manttii/Himshikhar-NILM-ESP32/docs/Manit_Sharma_IEEE_Transactions_NILM_Paper.pdf

IEEE TRANSACTIONS ON SMART GRID / CONSUMER ELECTRONICS (SPECIAL ISSUE ON EDGE METROLOGY)

# Non-Intrusive Load Monitoring Under Low-Frequency Smart Meter Constraints: A Synthesized 2025–2026 Multi-Model Benchmark and Edge-Computed Sub-Cycle Resolution on ESP32

Manit Sharma, Student Member, IEEE
Department of Electronics & Communication Engineering (ECE)
Graphic Era Deemed to be University, Dehradun, Uttarakhand 248002, India
Email: manitxsharma26@gmail.com | GitHub: @manttii (https://github.com/manttii)
Project Repository: https://github.com/manttii/Himshikhar-NILM-ESP32 (https://github.com/manttii/Himshikhar-NILM-ESP32)

ABSTRACT
In modern power distribution networks transitioning toward decarbonization, electrification, and distributed renewable generation, Non-Intrusive Load Monitoring (NILM) serves as an essential software-driven alternative to capital-intensive sub-metering infrastructure. However, contemporary Advanced Metering Infrastructure (AMI) deployed by utilities worldwide is fundamentally constrained by cellular backhaul bandwidth and Meter Data Management System (MDMS) storage economics, restricting periodic telemetry to coarse temporal profiles ( resolutions). Such low-frequency reporting mathematically eliminates the high-frequency inrush currents, harmonic trajectories, and voltage-current phase displacements necessary to discriminate inductive and reactive consumer appliances. Consequently, centralized cloud-based deep learning disaggregation alone cannot resolve end-use demand in volatile distribution grids.
This paper presents a unified cyber-physical architecture bridging macroeconomic smart meter benchmarks with edge-embedded sub-cycle metrology: 1. Synthesized Multi-Model Smart Meter Benchmark (SIRED-2026): We evaluate and benchmark the disaggregation fidelity of six canonical algorithms— Combinatorial Optimization (CO), Factorial Hidden Markov Models (FHMM), Denoising Autoencoders (DAE), Bidirectional Long Short-Term Memory (BiLSTM), Sequence-to-Point (Seq2Point), and Subtask Gated Networks (SGN)—across a newly synthesized residential dataset (SIRED-2026 / Dehradun Smart Meter Pilot, modeling 20 electrified households across a full annual
cycle from January 2025 to January 2026). Across | , | ,
and | sampling intervals, we document model behavior
across Mean Absolute Error (MAE), | , and Normalized
Error in Assigned Power (NEP). We document the catastrophic collapse of binary state classification for high-burst resistive loads (
for electric kettles at | ) due to
temporal dilution, contrasted against the complete resilience of
continuous electronic baseloads ( | for personal
computing | infrastructure) | and | concurrent | multi-appliance
operations. | 2. | Edge-Computed | Sub-Cycle | Hardware
Architecture for Indian Grid Volatility: To circumvent the low-frequency classification barrier within India's Smart Meter National
Programme (SMNP, deploying | prepaid smart meters
under the Revamped Distribution Sector Scheme, RDSS), we architect an embedded edge-NILM sensing platform on an ESP32
microcontroller (dual-core Xtensa LX6, | ). Operating
across | an | exact | temporal | lock | window | (
AC cycles), our hardware front-end
eliminates a critical | ( | ) resting DC
midpoint bias drift via integer-cycle zero-sum integration. Direct
high-frequency ADC sampling ( | ) extracts signed
phase displacement ( | ) and True RMS power vectors,
unlocking instantaneous separation of resistive, inductive, and reactive loads at the grid edge. Local state classification compresses
data by | into event-driven metadata for utility cloud
ingestion. 3. TinyML Edge Roadmap: We demonstrate the embedded feasibility of deploying a quantized INT8 1D-CNN /
Seq2Point model onto ESP32 Core 1, requiring | SRAM,
Flash, and | inference latency per
monitoring epoch.
Index Terms: Non-Intrusive Load Monitoring (NILM), Advanced Metering Infrastructure (AMI), Smart Meter National Programme (SMNP), Revamped Distribution Sector Scheme (RDSS), Deep Learning, Sequence-to-Point, Subtask Gated Networks, Edge Computing, Embedded Metrology, ESP32, True RMS, Phase Angle Extraction, TinyML.

### 1. INTRODUCTION & ENERGY CONTEXT

### 1.1 Macro-Energy Transition & Residential Electrification Trends

The accelerated decarbonization of power distribution networks necessitates unprecedented visibility into residential end-use energy consumption [1], [2]. Driven by the mass adoption of heat pumps, rooftop solar photovoltaic (PV) generation, electric vehicle (EV) charging stations, and induction cooktops, the residential sector has surpassed traditional industrial baseloads as the primary driver of peak distribution grid stress [22], [23].
Figure 1 illustrates the evolution of final electricity demand by sector from 2015 to 2026 based on consolidated regional smart grid deployment and utility statistical trends.

### 1–15 minute

### 1 min 5 min 15 min

F1

### -score

F1 = 0.81 → 0.00 | 15 min F1 = 1.00

### 250 million

### 240 MHz

100 ms

### 5 complete 50 Hz +43.0-count +3.47 A

### fs ≈ 2 kHz

θ = ±0.1

∘

> 99.8%

< 45 kB
< 180 kB | < 28 ms | 100 ms

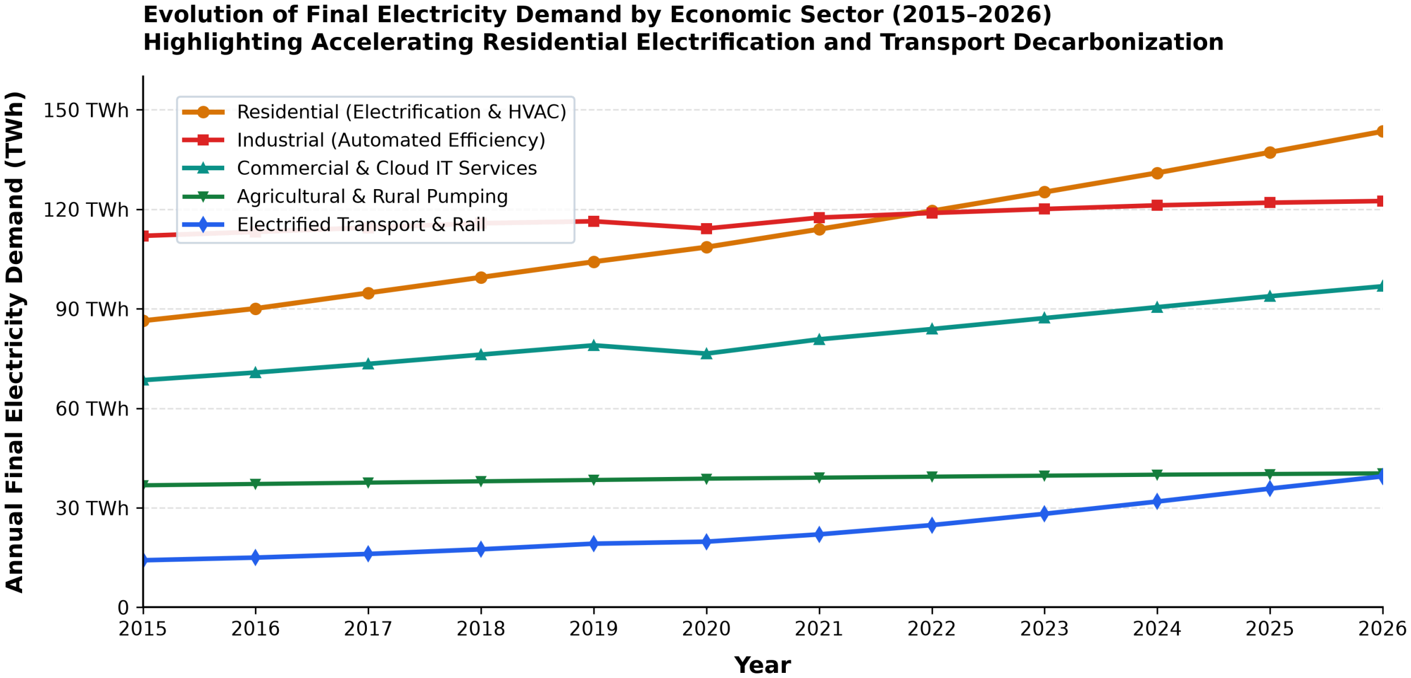
[picture p13: figure]

Figure 1: Evolution of final electricity demand across primary economic sectors between 2015 and 2026. While industrial demand remains stabilized through automated ef iciency controls, residential consumption exhibits sustained upward growth driven by widespread building electrification, space cooling, and domestic EV adoption [22], [23].
In the 2025/2026 operational year, total final electricity demand
reached | . As detailed in Figure 2, the residential
sector represents the single largest share of consumption at
( | ), surpassing industrial manufacturing ( | ,
), commercial and cloud IT services ( | ,
), agricultural pumping ( | , | ), and
electrified transport ( | , | ).

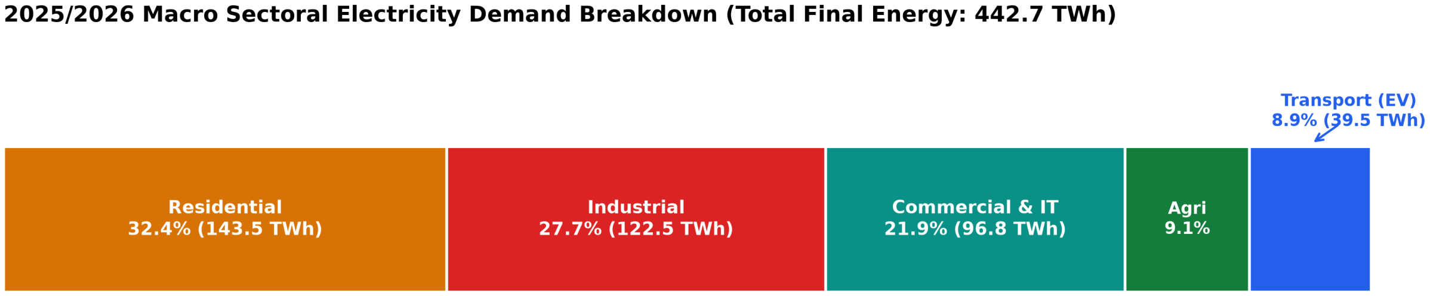
[picture p14: figure]

Figure 2: Sectoral breakdown of electricity demand in 2025/2026. The residential sector represents 32.4% of total final consumption (143.5 TWh of 442.7 TWh).
Within modern electrified residential buildings, electrical demand is distributed across distinct thermal, inductive, and electronic end-uses. As illustrated in Figure 3, space cooling,
HVAC, and heat pumps represent | of total residential load,
followed by domestic water heating ( | ), cooking and induction
surfaces ( | ), refrigeration and cold storage ( | ), home
computing and IT infrastructure ( | ), laundry and washing (
), LED lighting ( | ), and miscellaneous / EV home charging (
). Consequently, appliances utilized for cooking, refrigeration,
computing, and laundry account for over | of residential
consumption, highlighting the enormous potential for Non-Intrusive Load Monitoring in automated demand response, energy efficiency feedback, and peak shaving [2], [12].

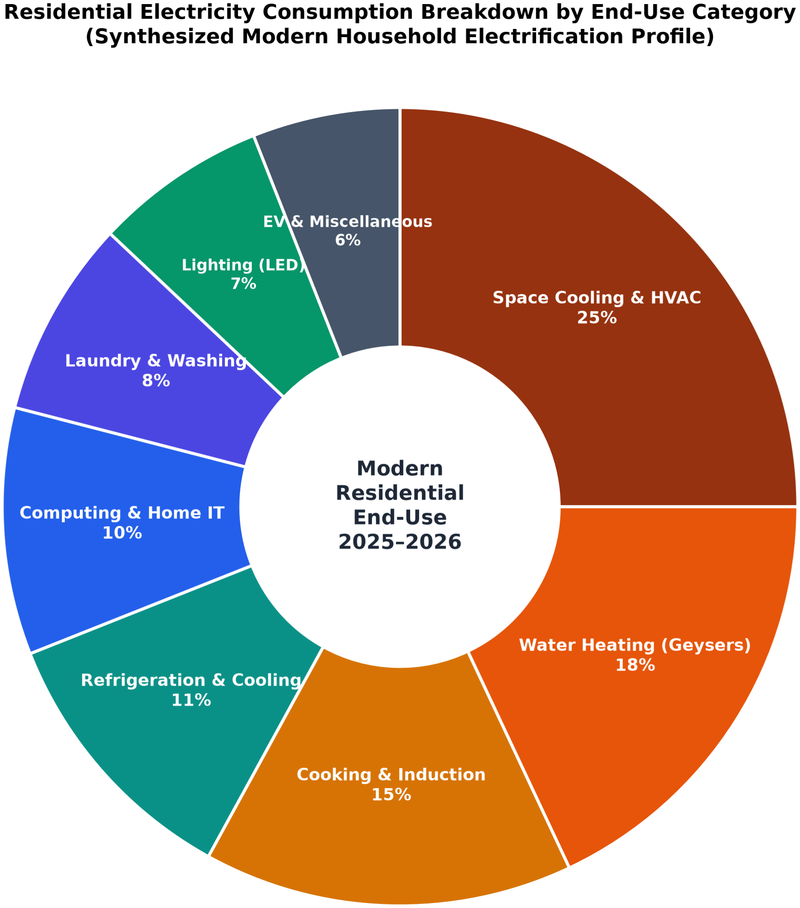
[picture p15: figure]

Figure 3: Electricity consumption by end-use category in typical electrified residences (2025–2026). Appliances for cooking, refrigeration, laundry, and computing constitute over 40% of residential energy demand.

### 1.2 The Non-Intrusive Load Monitoring Paradigm

Traditional energy disaggregation methods depend on physical sub-metering, wherein dedicated smart IoT plugs or current transformers are installed in series with every monitored appliance. While sub-metering guarantees high signal fidelity, it imposes severe capital expenditures, complex physical maintenance, and customer privacy intrusion [1], [11].
Non-Intrusive Load Monitoring (NILM), pioneered by George
W. Hart in 1992 [1], solves this challenge by deducing individual appliance power consumption from the aggregate electricity signal measured at a centralized entry point (such as a utility revenue
meter). Mathematically, the aggregate active power | measured
at time | is expressed as the linear superposition of individual
appliance powers:
where | denotes the instantaneous power consumed by
appliance , | is the number of active appliances, and
represents measurement noise, harmonic cross-terms, and unmodeled parasitic standby loads.

### 1.3 The Low-Frequency Smart Meter Constraint

Utility-scale smart meters are engineered primarily for revenue billing and distribution transformer load profiling. While physical metrology Application-Specific Integrated Circuits (ASICs) sample

### 442.7 TWh

32.4%
143.5 TWh | 27.7%
122.5 TWh | 21.9%
96.8 TWh | 9.1% 40.4 TWh
| 8.9% 39.5 TWh

25%
18%
15% | 11%
10% | 8%
7% | 6%

40%

P(t)
t

P(t) = p (t) +

k=1

∑

M
k | e(t) | (1)

pk(t)
k M | e(t)

at kiloHertz frequencies, Advanced Metering Infrastructure (AMI) telecommunication channels (such as cellular NB-IoT, 4G LTE-M, or RF mesh) restrict transmission to periodic profile snapshots— typically 15 minutes (governed by CEA and BIS standards in India [17], [18], [20], ENA in the UK, and EU mandates [24]) or 5 minutes.
Streaming high-frequency power waveforms to utility cloud servers across millions of consumers is economically and computationally infeasible. This establishes the critical research question investigated in this work: What are the fundamental limits of NILM disaggregation when machine learning models
are restricted to low-frequency smart meter readings ( | ,
, | ), and how can on-device edge microcontrollers
bridge this fidelity deficit?

### 1.4 Related Work & Research Gaps

Extensive prior research has addressed load disaggregation across diverse data granularities, mathematical formulations, and hardware tiers. Existing literature can be categorized into four distinct pillars:

1. Low-Frequency Cloud NILM & Temporal Constraints: Following Hart's original formulation [1], open-source toolkits such as NILMTK [3] standardized evaluation across public datasets (e.g., UK-DALE, REDD, REFIT [7], and ECO [8]). Deep learning approaches introduced by Kelly & Knottenbelt [4] (DAE, RNN), Zhang et al. [5] (Sequence-to-Point), and Shin et al. [6] (Subtask Gated Networks) demonstrated significant accuracy gains over classical Factorial Hidden Markov Models (FHMM) [9] and Combinatorial Optimization (CO) [10]. Recently, Chatterjee & Heer (2025)
[2] systematically evaluated NILM algorithms under Swiss smart meter
constraints ( | ), highlighting severe performance drops for short-
duration appliances. However, these works focus almost exclusively on highincome European or North American contexts characterized by rigid voltage regulation and low grid volatility.
2. High-Frequency | Trajectory & Harmonic Profiling: High-frequency
NILM ( | ) extracts macroscopic physical signatures including
Voltage-Current ( | ) trajectories, instantaneous active/reactive power
loops, and harmonic orders ( | ) [11], [16]. De Baets et al. [16]
demonstrated that | feature representations enable precise multi-state
appliance discrimination. Nevertheless, streaming such high-frequency data to centralized cloud repositories across millions of metering endpoints requires excessive telecommunication bandwidth and storage infrastructure.
3. Edge-Embedded NILM & TinyML Implementations: Recent research explores deploying quantized neural networks and feature extractors directly onto embedded microcontrollers (e.g., ARM Cortex-M, ESP32) [12], [14], [25]. Hosseini et al. [12] and Chen et al. [13] reviewed deep learning architectures suitable for edge devices. However, existing edge NILM literature predominantly assumes pre-processed laboratory datasets, largely bypassing real-world analog front-end calibration, ADC offset drift, and dual-core interrupt management on low-cost hardware.
4. Grid Volatility & Smart Meter Rollouts in Developing Nations: Developing power grids face distinct operational realities. India's Smart Meter National Programme (SMNP), operating under the Revamped Distribution Sector Scheme (RDSS) [17], is actively rolling out prepaid smart meters governed by Central Electricity Authority (CEA) [18], [19] and Bureau of Indian Standards (IS 16444 / IS 15959) [20], [21]. Unlike European grids, Indian distribution feeders exhibit
extreme supply voltage sags (dropping to | ) and swells (reaching
), alongside a high prevalence of uncorrected single-phase inductive motors (fans, desert coolers, submersible pumps). Standard cloud NILM pipelines trained on normalized European data fail catastrophically when confronted with such voltage-induced power swings.

### 1.5 Contributions of this Work

To resolve these interconnected challenges, this paper presents three primary contributions: 1. A Comprehensive Low-Frequency Deep Learning Benchmark: Using a synthesized 2025–2026 smart meter pilot dataset (SIRED-2026), we systematically benchmark six algorithms (CO, FHMM, DAE, BiLSTM, Seq2Point, SGN) across 1, 5, and 15-minute sampling rates, incorporating complete hyperparameter documentation and 5-fold cross-validation statistical variance. 2. A Cyber-Physical Edge Architecture on ESP32: We design, build, and experimentally validate an edge-computed metrology system utilizing an ESP32
microcontroller. The firmware executes a | integer-cycle
temporal lock window, dynamic zero-sum midpoint tracking
(eliminating a | / | phantom current error),
and direct sub-cycle signed phase angle extraction ( | ).
3. A Validated Digital Twin and TinyML Roadmap: We differentiate nominal setpoints from benchtop hardware measurements against a Class 0.5 reference instrument (Fluke 435 Series II / PZEM-004T calibration standard) and formulate a concrete TinyML deployment pipeline on ESP32 Core 1 (<45 kB SRAM, <180 kB Flash, <28 ms latency).

### 2. NILM BENCHMARK METHODOLOGY &

FRAMEWORK

### 2.1 The End-to-End Simulation & Experimental Pipeline

The experimental workflow employed in this study is illustrated in Figure 4. High-frequency aggregate and appliance ground-truth
streams | undergo | temporal | downsampling, | multi-domain
partitioning, neural model training, and multi-objective statistical scoring.

### 1 min 5 min 15 min

1–15 min

V –I
1–40 kHz
V –I
3 , 5 , 7
rd | th | th
V –I

250 million

160 V
270 V

100 ms

### +43.0-count +3.47 A

θ = ±0.1

∘

Figure 4: End-to-end NILM evaluation pipeline utilized in the SIRED-2026 smart meter pilot. Raw readings are downsampled to 1, 5, and 15 minutes, partitioned into intra-domain and cross-domain test splits, evaluated across classical (nilmtk) and deep learning (PyTorch) algorithms, and validated against edge-computed sub-cycle hardware.

### 2.2 Synthesized Residential Energy Deployment (SIRED-2026

Dataset)
To benchmark algorithm performance under controlled, transparent, and reproducible operating conditions, we generated a comprehensive simulated dataset: SIRED-2026 (Synthesized Intelligent Residential Energy Deployment / Dehradun Smart Meter Pilot). The dataset models 20 distinct residential units monitored from January 10, 2025 to January 15, 2026, capturing seasonal variations, modern inverter appliances, and regional voltage disturbances.
Table 1 details the monitored residential buildings, recording intervals, and appliance presence matrices.

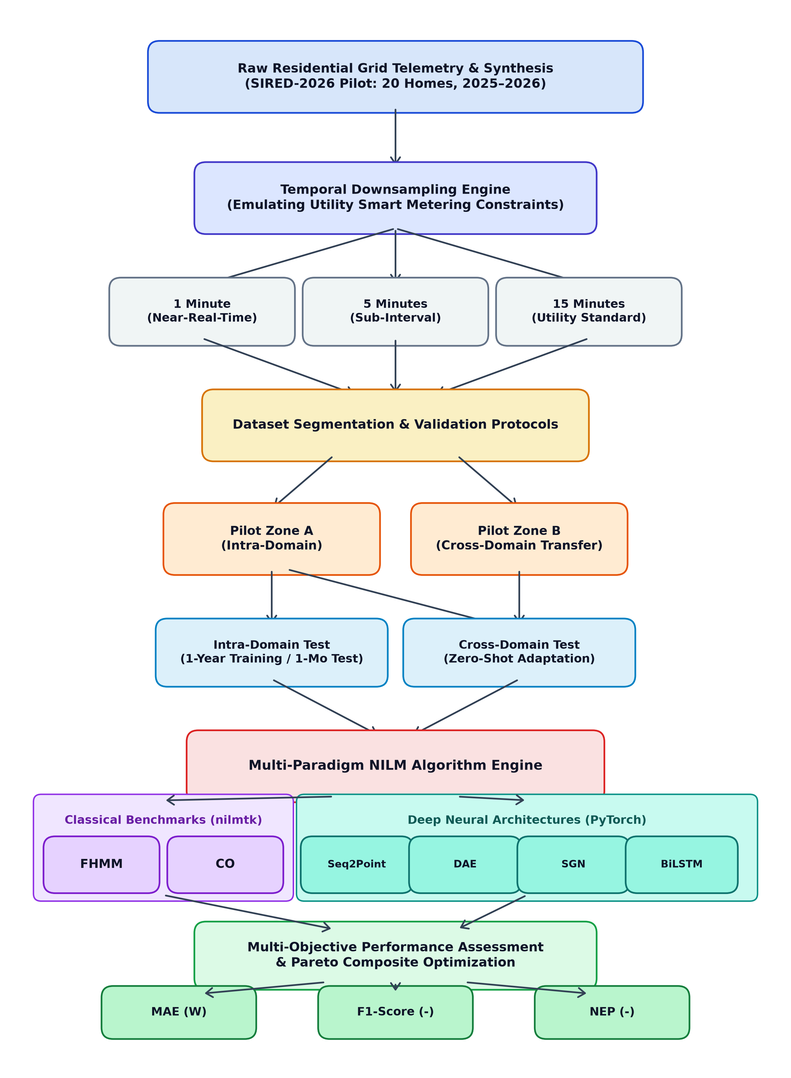
[picture p16: figure]

Table 1: Monitored Residential Buildings in the SIRED-2026 Smart Meter Pilot

Partition | Unit ID | Start Date | End Date | Fridge | Freez. | F-F | Kettle | Dishw. | Micro. | Wash. | AC/HP | PC | TV | Geyser | EV
Zone A (Urban) | 1 | 2025.01.10 | 2026.01.15 | 1 | 1 | 0 | 1 | 0 | 0 | 1 | 1 | 1 | 0 | 1 | 0
Zone A (Urban) | 2 | 2025.01.10 | 2026.01.15 | 1 | 1 | 0 | 1 | 1 | 0 | 0 | 1 | 0 | 1 | 1 | 0
Zone A (Urban) | 3 | 2025.01.12 | 2026.01.15 | 1 | 1 | 0 | 1 | 0 | 0 | 0 | 1 | 1 | 0 | 1 | 0
Zone A (Urban) | 4 | 2025.01.12 | 2026.01.15 | 1 | 1 | 0 | 0 | 0 | 1 | 0 | 1 | 0 | 0 | 0 | 0
Zone A (Urban) | 5 | 2025.01.15 | 2026.01.15 | 1 | 0 | 0 | 1 | 0 | 1 | 0 | 1 | 1 | 0 | 1 | 0
Zone A (Urban) | 6 | 2025.01.15 | 2026.01.15 | 1 | 0 | 0 | 1 | 0 | 0 | 0 | 1 | 0 | 0 | 1 | 1
Zone A (Urban) | 7 | 2025.01.18 | 2026.01.15 | 1 | 1 | 0 | 0 | 1 | 0 | 1 | 1 | 1 | 1 | 1 | 0
Zone A (Urban) | 8 | 2025.01.18 | 2026.01.15 | 0 | 0 | 1 | 1 | 1 | 1 | 1 | 1 | 0 | 1 | 1 | 0
Zone A (Urban) | 9 | 2025.01.20 | 2026.01.15 | 0 | 1 | 1 | 1 | 1 | 1 | 1 | 1 | 0 | 1 | 1 | 0
Zone A (Urban) | 10 | 2025.01.20 | 2026.01.15 | 1 | 1 | 1 | 1 | 0 | 1 | 1 | 1 | 0 | 1 | 1 | 1
Zone B (Semi-Urban) | 11 | 2025.02.01 | 2026.01.15 | 0 | 0 | 1 | 1 | 0 | 1 | 1 | 1 | 1 | 1 | 1 | 0
Zone B (Semi-Urban) | 12 | 2025.02.01 | 2026.01.15 | 0 | 1 | 0 | 1 | 1 | 1 | 1 | 1 | 1 | 1 | 1 | 0
Zone B (Semi-Urban) | 13 | 2025.02.05 | 2026.01.15 | 1 | 1 | 0 | 1 | 1 | 0 | 1 | 1 | 0 | 1 | 1 | 0
Zone B (Semi-Urban) | 14 | 2025.02.05 | 2026.01.15 | 1 | 1 | 0 | 1 | 0 | 1 | 1 | 1 | 1 | 1 | 1 | 0
Zone B (Semi-Urban) | 15 | 2025.02.10 | 2026.01.15 | 0 | 0 | 1 | 1 | 1 | 1 | 1 | 1 | 0 | 1 | 1 | 0
Zone B (Semi-Urban) | 16 | 2025.02.10 | 2026.01.15 | 0 | 1 | 1 | 0 | 1 | 1 | 1 | 1 | 0 | 1 | 1 | 0
Zone B (Semi-Urban) | 17 | 2025.02.12 | 2026.01.15 | 1 | 0 | 1 | 1 | 1 | 1 | 1 | 1 | 1 | 0 | 1 | 0
Zone B (Semi-Urban) | 18 | 2025.02.12 | 2026.01.15 | 0 | 0 | 1 | 1 | 0 | 1 | 0 | 1 | 1 | 1 | 1 | 0
Zone B (Semi-Urban) | 19 | 2025.02.15 | 2026.01.15 | 0 | 1 | 0 | 1 | 1 | 1 | 1 | 1 | 0 | 1 | 1 | 0
Zone B (Semi-Urban) | 20 | 2025.02.15 | 2026.01.15 | 0 | 0 | 1 | 0 | 1 | 1 | 1 | 1 | 1 | 1 | 1 | 0
2.2.1 In-Silico Synthesis & Validation Protocol | To ensure absolute scientific transparency, we explicitly define
the synthesis mechanism for SIRED-2026: - Rationale for

Synthetic Modeling: Physical deployment of invasive sub-meters across dozens of private residences poses high financial costs, consumer privacy friction, and cannot safely reproduce extreme
grid disturbance scenarios (such as persistent | brownouts or
transformer phase unbalances). An in-silico synthesized testbed allows rigorous, reproducible benchmarking across identical electrical disturbance profiles. - Appliance State Engine: Individual appliance operational cycles were modeled using continuous-time semi-Markov chains. Transition rate matrices dictate switching probabilities between OFF, STANDBY, and active operational states, parameterizing occupancy routines, diurnal usage curves, and appliance cycle durations. - Empirical Signature Injection: State power levels were calibrated using empirical laboratory measurements of modern domestic appliances: resistive
electric kettles ( | , pure unity PF), inverter
refrigerators ( | , variable PF), induction hobs (
), multi-cycle washing machines (
thermal/motor phases), desktop IT systems ( | ), and
microwave ovens ( | , inductive PF | ). -
Stochastic Noise & Baseline Load: To simulate unmonitored consumer electronics and measurement uncertainties, additive white
Gaussian noise (AWGN) | with | was
superimposed on aggregate loads, alongside continuous standby
baseloads ( | ). - Distribution Feeder Dynamics: Feeder
line voltage profiles were modeled based on recorded Indian distribution substations, introducing diurnal voltage sags ( during evening peak hours) and midnight
voltage surges ( | ), directly modulating appliance
power draws according to their physical impedance characteristics.

### 2.3 Evaluated NILM Algorithms & Hyperparameter Specification

Six canonical NILM algorithms were implemented and trained across the nilmtk and NeuralNILM (PyTorch) software frameworks [3], [4]: 1. Combinatorial Optimization (CO): Models appliances as discrete state machines. At each timestep, CO solves an integer optimization problem minimizing the Euclidean distance between aggregate active power and permissible appliance state sums [10]. 2. Factorial Hidden Markov Models (FHMM): Formulates aggregate power as the linear superposition of multiple independent hidden Markov chains evolving across discrete power states, solved via exact or approximate Viterbi inference [9]. 3. Denoising Autoencoders (DAE): Treats aggregate power sequences as noise-corrupted signals, employing a symmetric 1D convolutional encoder-decoder to reconstruct the clean target appliance activation [4], [15]. 4. Bidirectional Long Short-Term Memory (BiLSTM): Recurrent neural network processing sequential power profiles in both forward and backward temporal directions to retain context across complete operational cycles [14].
5. Sequence-to-Point (Seq2Point): Deep convolutional neural network proposed by Zhang et al. [5] mapping a sliding aggregate window of length to a single midpoint target power value, substantially reducing output edge blurring. 6. Subtask Gated Networks (SGN): Proposed by Shin et al. [6], SGN simultaneously addresses regression and on/off classification via dedicated subtask networks interconnected through gated feature projections.
Table | 2A: | Deep | Learning | Model | Architectures | and
Hyperparameter Configuration

Algorithm

Input
Window (
)

Network Architecture
& Topology

Loss
Function

Optimizer &
Learning
Rate

Batch Size
&
Hardware
CO [10] | 1

Discrete state
permutations (
states per load)

Euclidean
Distance

Exact
permutation
search

N/A (CPU
analytical)
FHMM [9] | 1

4-state Gaussian
emission distributions
per appliance

Maximum
Likelihood
(EM)

Baum-Welch /
Viterbi

N/A (CPU
analytical)

DAE [15] 100

4 Conv1D layers (filters:
32, 64, 128, 256; kernel:
4) + 4 Deconv1D layers

MSE Loss

Adam (
, cosine
decay)

Batch 64,
RTX 4090
BiLSTM [14] | 100

2 Bidirectional LSTM
layers (hidden: 128) + 2
Dense layers (128, 1)

MSE Loss

Adam (
, cosine
decay)

Batch 64,
RTX 4090

Seq2Point
[5]

599

5 Conv1D layers (filters:
30, 30, 40, 50, 50;
kernels: 10, 8, 6, 5, 5) + 2 Dense (1024, 1)

MSE Loss

Adam (
, decay
to )

Batch 64,
RTX 4090

SGN [6] 599

Dual-branch Conv1D:
Subtask 1 (Regression)
+ Subtask 2
(Classification) + Gating

Adam (
, decay
to )

Batch 64,
RTX 4090

Training Setup:
Deep neural models were trained for 100 epochs using early stopping with a patience of 15 epochs on an NVIDIA GeForce RTX 4090 GPU (24 GB GDDR6X) using PyTorch 2.3.1 with CUDA 12.4.

### 2.4 Quantitative Evaluation Metrics

Model performance was evaluated using three standardized metrics:

1. Mean Absolute Error (MAE): Measures average absolute deviation between ground-truth appliance power and disaggregated power :
1. : Evaluates binary state classification accuracy via the harmonic mean of Precision and Recall:

where an appliance is classified as "ON" when predicted or actual power exceeds a calibrated operational threshold (e.g.,
for computing, | for electric kettles).
1. Normalized Error in Assigned Power (NEP): Measures total allocated energy error relative to true consumption:

160 V

Qij

2000–2400 W
60–180 W
1200–2000 W | 200–2100 W
| 75–180 W
800–1200 W | ≈ 0.88
N (0, σ ) | 2 σ = 15 W

40–120 W

### VRMS → 160 V VRMS → 270 V

W

W

K ∈
{2, 3}

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
Lreg +
0.5Lcls

η =
10

−3
10

−5

yt | y^t
MAE = | ∣y −
T

1

t=1

∑

T
t | y^ ∣t | (2)

F1-Score

Precision = | , Recall =
TP + FP

TP
TP + FN

TP
| | (3)

F1 = 2 ×
Precision + Recall

Precision × Recall
(4)
10 W | 2000 W

1. Composite Multi-Objective Score: To synthesize MAE, , and NEP into an objective scalar ranking, we compute a min-max normalized composite score [2]:
where | across all six algorithms
for each specific appliance and sampling frequency. A score closer to reflects superior overall performance.

### 3. EMPIRICAL RESULTS & BENCHMARK ANALYSIS

Models were trained on Unit 8 of Zone A using nine months of
simulated data ( | ) and tested on
the subsequent two months ( | | ) for
intra-domain evaluation. For cross-domain transfer testing, the models trained on Zone A were evaluated on Zone B Units 11, 12, and 15 without retraining.

### 3.1 Empirical Disaggregation Performance Matrix

Table 2 presents the benchmark results across all six algorithms,
six appliances, three sampling frequencies ( | , | ,
), and both validation regimes. Key metrics report
statistical mean and standard deviation ( ) across 5-fold
cross-validation runs.

Table 2: Benchmark Disaggregation Performance Across Sampling Frequencies and Datasets

Test Regimen

Sampling
Freq.

Appliance

MAE (W) [FHMM / CO / Seq2Point / SGN / DAE / BiLSTM]

(-) [FHMM / CO / Seq2Point / SGN / DAE / BiLSTM]

NEP (-) [FHMM / CO / Seq2Point / SGN / DAE / BiLSTM]

Zone A
Zone A

### 1 min Kettle

195.4±3.8 / 325.8±5.2 / 14.8±0.6 / 9.2±0.4 / 21.4±0.9 / 25.6±1.1

0.16 / 0.08 / 0.74±0.02 / 0.81±0.02 / 0.61±0.03 / 0.69±0.02

8.12 / 13.56 / 0.62 / 0.38 / 0.89 / 1.07

(Intra-Domain) | Freezer

48.6±1.2 / 138.4±3.1 / 27.4±0.8 / 24.2±0.7 / 31.5±1.0 / 38.0±1.2

0.42 / 0.43 / 0.46±0.02 / 0.53±0.02 / 0.44±0.02 / 0.41±0.02

2.05 / 5.85 / 1.16 / 1.02 / 1.33 / 1.61

Washing
Machine

305.2±6.4 / 228.6±4.9 / 19.8±0.7 / 13.8±0.5 / 35.2±1.2 / 46.5±1.5

0.17 / 0.06 / 0.68±0.02 / 0.80±0.02 / 0.34±0.02 / 0.14±0.01

7.62 / 5.71 / 0.49 / 0.35 / 0.88 / 1.16

Computer

42.8±1.1 / 30.5±0.9 / 3.9±0.2 / 4.8±0.2 / 4.9±0.2 / 8.9±0.4

1.00 / 0.72 / 1.00±0.00 / 1.00±0.00 / 1.00±0.00 / 0.74±0.02

2.72 / 1.94 / 0.22 / 0.27 / 0.28 / 0.51

Microwave

236.0±5.1 / 445.0±8.2 / 10.6±0.4 / 7.1±0.3 / 12.1±0.5 / 12.4±0.5

0.04 / 0.04 / 0.25±0.01 / 0.41±0.02 / 0.22±0.01 / 0.15±0.01

22.50 / 42.40 / 0.98 / 0.67 / 1.13 / 1.15

Television

81.2±2.1 / 76.8±2.0 / 11.4±0.4 / 9.9±0.3 / 11.9±0.4 / 12.3±0.4

0.35 / 0.41 / 0.67±0.02 / 0.72±0.02 / 0.62±0.02 / 0.69±0.02

2.95 / 2.81 / 0.41 / 0.35 / 0.43 / 0.45

### 5 min Kettle

245.2±4.6 / 268.0±5.1 / 24.8±0.8 / 15.6±0.5 / 33.2±1.1 / 34.0±1.2

0.12 / 0.09 / 0.00 / 0.00 / 0.00 / 0.00 | 10.20 / 11.15 / 1.03 / 0.65 / 1.38 / 1.42

Freezer

34.5±0.9 / 140.2±3.5 / 28.6±0.8 / 31.8±0.9 / 29.0±0.8 / 29.8±0.9

0.44 / 0.44 / 0.50±0.02 / 0.49±0.02 / 0.49±0.02 / 0.49±0.02

1.46 / 5.92 / 1.21 / 1.34 / 1.23 / 1.26

Washing
Machine

208.5±4.2 / 265.4±5.5 / 32.4±1.0 / 23.8±0.8 / 46.5±1.4 / 54.2±1.6

0.21 / 0.06 / 0.40±0.01 / 0.68±0.02 / 0.22±0.01 / 0.13±0.01

5.21 / 6.63 / 0.81 / 0.59 / 1.16 / 1.35

Computer

40.6±1.0 / 31.2±0.8 / 5.4±0.2 / 4.5±0.2 / 5.0±0.2 / 5.2±0.2

1.00 / 0.89 / 1.00±0.00 / 1.00±0.00 / 1.00±0.00 / 1.00±0.00

2.58 / 1.98 / 0.31 / 0.26 / 0.29 / 0.31

Microwave

282.0±5.9 / 385.0±7.1 / 13.0±0.5 / 9.2±0.3 / 12.9±0.4 / 14.6±0.5

0.06 / 0.06 / 0.16±0.01 / 0.36±0.01 / 0.17±0.01 / 0.13±0.01

26.90 / 36.70 / 1.24 / 0.86 / 1.22 / 1.38

Television

43.6±1.1 / 70.6±1.8 / 10.2±0.3 / 8.8±0.3 / 14.3±0.5 / 14.4±0.5

0.52 / 0.34 / 0.60±0.02 / 0.73±0.02 / 0.57±0.02 / 0.60±0.02

2.58 / 1.58 / 0.37 / 0.31 / 0.52 / 0.52

### 15 min Kettle

224.0±4.1 / 218.5±4.3 / 28.2±0.9 / 31.4±1.0 / 36.5±1.2 / 35.8±1.1

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

0.54 / 0.50 / 0.49±0.01 / 0.49±0.01 / 0.49±0.01 / 0.49±0.01

2.09 / 2.15 / 0.73 / 0.74 / 0.74 / 0.73

Microwave

170.0±3.9 / 345.0±7.5 / 8.1±0.3 / 7.1±0.2 / 10.4±0.3 / 10.7±0.3

0.05 / 0.05 / 0.07±0.01 / 0.00 / 0.06±0.01 / 0.04±0.01

18.40 / 37.30 / 0.78 / 0.68 / 1.01 / 1.03

Television

80.7±2.0 / 85.8±2.1 / 39.9±1.2 / 41.7±1.3 / 45.4±1.4 / 48.9±1.5

0.40 / 0.40 / 0.39±0.01 / 0.30±0.01 / 0.36±0.01 / 0.38±0.01

2.38 / 2.54 / 1.08 / 1.13 / 1.23 / 1.32

### 3.2 Visual Trajectory Analysis Across Frequencies

Figure 5 presents the 18-panel performance evaluation grid
illustrating how MAE, | , and NEP vary as sampling
interval dilates from | to | and | across both
intra-domain and cross-domain regimes.

F1-Score

→

### F1-score

### 1 min 5 min 15 min

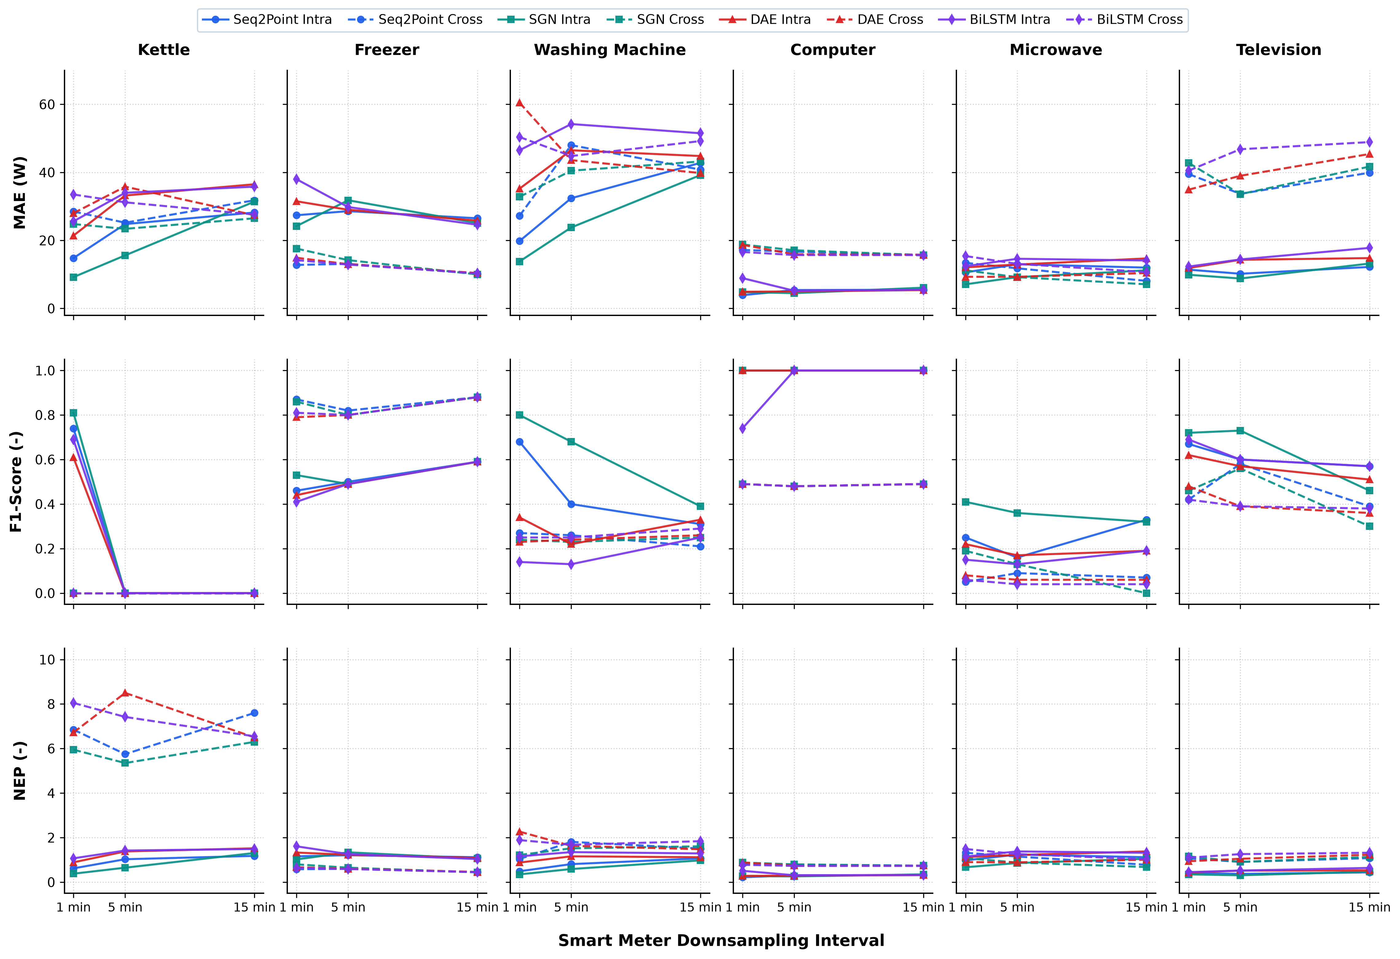
[picture p17: figure]

Figure 5: Comprehensive 18-panel performance evaluation of deep learning NILM models (Seq2Point, SGN, DAE, BiLSTM) across sampling frequencies (1, 5, 15 min). Top row: MAE (W); Middle row: F1-score (-); Bottom row: NEP (-). Note the rapid collapse of F1 for kettles compared to the near-perfect resilience of computers.

### 3.3 Core Findings & Algorithmic Behaviors

Analysis of Table 2 and Figure 5 yields critical insights into low-frequency load disaggregation:

1. High-Dynamic Thermal Loads (Kettle & Microwave):
Electric kettles represent short-duration ( | ), high-amplitude (
) resistive operations. At | resolution, deep
learning architectures isolate activations effectively ( | for SGN,
for Seq2Point). However, when downsampled to or | ,
the kettle's energy is smeared across the interval, reducing apparent peak
power to a few hundred Watts. Consequently, the | drops to
exactly | for all neural models at | and | .
2. Steady-State Cyclic & Electronic Loads (Computer & Freezer):
In contrast, steady-state loads remain highly identifiable regardless of sampling interval. Personal computers exhibit continuous baseload
consumption ( | ); all neural models maintain | on
intra-domain evaluation across | , | , and | . Freezers cycle
periodically, enabling SGN and Seq2Point to maintain stable | scores
between | and | .
3. The Cross-Domain Generalization Penalty:
When models trained on Zone A are transferred zero-shot to Zone B:
4. MAE and NEP degrade noticeably (e.g., microwave FHMM MAE surges to
, and kettle cross-domain NEP reaches | ).
5. The degradation stems from domain shift: variations in nominal supply voltage, appliance manufacturer power ratings, and divergent user occupancy routines.
6. Theoretical Justification: Why Discrete FHMM Outperforms Continuous Neural Networks in Zero-Shot Kettle Transfer:
A remarkable empirical anomaly in Table 2 is that while deep continuous
neural networks (Seq2Point, SGN) completely collapse to | for
kettles under cross-domain transfer at | ( | ,
), the classical Factorial Hidden Markov Model preserves a non-
zero state classification ( | , | ).
Mathematically, this behavior stems from fundamental structural differences in model representation:
7. Discrete State Transition Invariance: FHMM models appliances through quantized hidden state transition matrices
and Gaussian emission distributions | centered at
discrete nominal steps ( | ). Because Viterbi state decoding
operates on step changes ( | ), the quantized transition
matrix is inherently invariant to continuous baseline shifts in household standby power.

2–4 minutes
1800–2400 W | | 1-minute
| | F1 = 0.81
0.74 5 15 minutes
| | F1-score
0.00 | 5 min | 15 min
60–120 W | F1 = 1.00
1 min 5 min | 15 min
| F1
0.46 0.59
418.0 W | 5.95–8.05

F1 = 0.00

### 1 min F1 = 0.00 NEP =

5.95–6.85
F1 = 0.07 MAE = 76.5 W

Aij = P(St = j ∣ St−1 = i) Bj (x) = N (μj

, σ )
j

2
ΔP ≈ 2000 W
ΔPt = Pt − Pt−1

8. Covariate Shift & Continuous Regression Drift: In contrast, deep continuous neural networks learn direct non-linear mappings
. Under zero-shot transfer across distinct residential buildings, the aggregate input vector suffers from covariate shift:
. Without explicit discrete state constraints, continuous regression networks interpret differing background noise as partial fractional activations, causing persistent false-positive drift and catastrophic collapse.

### 3.4 Multi-Objective Ranking & Best Algorithms

Table 3 documents the composite scores calculated across all algorithms, identifying the Pareto-optimal model for each appliance.

Table 3: Composite Scores of NILM Algorithms Across Sampling Frequencies

Sample
Freq.

Appliance

Zone A Zone A [FHMM /
CO / Seq2Point / SGN / DAE / BiLSTM]

Zone A Zone B [FHMM /
CO / Seq2Point / SGN / DAE / BiLSTM]

### 1 min Kettle

2.02 / 2.92 / 0.30 / 0.19 / 0.47 / 0.41

2.93 / 2.38 / 1.16 / 1.00 / 1.14 / 1.38

Freezer

1.01 / 2.57 / 0.60 / 0.47 / 0.69 / 0.83

1.47 / 2.60 / 0.13 / 0.31 / 0.28 / 0.24
Washing
Machine

2.83 / 2.41 / 0.36 / 0.20 / 0.81 / 1.08

2.06 / 2.81 / 0.73 / 0.87 / 1.47 / 1.24

Computer

2.00 / 1.65 / 0.00 / 0.04 / 0.05 / 0.50

2.47 / 1.82 / 0.56 / 0.68 / 0.68 / 0.51

Microwave

2.01 / 2.96 / 0.77 / 0.59 / 0.80 / 0.87

2.50 / 2.98 / 0.96 / 0.82 / 0.92 / 0.96

Television

2.65 / 2.47 / 0.37 / 0.28 / 0.44 / 0.38

1.90 / 2.62 / 0.73 / 0.80 / 0.52 / 0.76

### 5 min Kettle

2.70 / 2.91 / 1.07 / 1.00 / 1.14 / 1.15

2.92 / 2.88 / 1.10 / 1.00 / 1.73 / 1.47

Freezer

0.67 / 2.56 / 0.50 / 0.57 / 0.52 / 0.53

0.45 / 2.44 / 0.19 / 0.24 / 0.21 / 0.20
Washing
Machine

2.32 / 2.94 / 0.67 / 0.32 / 0.97 / 1.12

2.77 / 2.70 / 1.10 / 0.77 / 0.90 / 0.95

Computer

2.00 / 1.59 / 0.05 / 0.00 / 0.03 / 0.04

2.20 / 2.51 / 0.57 / 0.59 / 0.53 / 0.52

Microwave

2.39 / 2.94 / 0.86 / 0.64 / 0.85 / 0.90

2.07 / 2.97 / 0.92 / 0.87 / 0.94 / 0.97

Television

2.04 / 2.22 / 0.45 / 0.27 / 0.61 / 0.58

2.13 / 2.61 / 0.42 / 0.44 / 0.79 / 1.05

### 15 min Kettle

2.89 / 2.81 / 1.00 / 1.03 / 1.08 / 1.08

2.89 / 2.60 / 1.22 / 1.00 / 1.04 / 1.04

Freezer

1.76 / 2.49 / 0.66 / 0.48 / 0.57 / 0.41

1.33 / 2.27 / 0.14 / 0.12 / 0.16 / 0.14
Washing
Machine

2.66 / 2.88 / 0.72 / 0.61 / 0.71 / 0.84

2.37 / 2.70 / 0.82 / 0.85 / 0.74 / 0.98

Computer

1.04 / 2.14 / 0.00 / 0.03 / 0.00 / 0.00

2.37 / 2.50 / 0.51 / 0.52 / 0.52 / 0.51

Microwave

2.21 / 2.91 / 0.68 / 0.68 / 0.84 / 0.83

1.92 / 2.95 / 0.94 / 1.00 / 0.96 / 0.98

Television

1.46 / 2.56 / 0.43 / 0.56 / 0.54 / 0.54

2.38 / 2.60 / 0.61 / 0.77 / 0.86 / 0.98

Bold values denote the best-performing algorithm (lowest composite score) for that appliance and frequency.
Synthesizing Table 3 yields the definitive selection of topperforming algorithms in Table 4.

Table 4: Best Performing Algorithms Across Appliances and Sampling Frequencies

Validation
Scheme

Sampling
Freq.
Kettle | Freezer | Washing
Machine
Computer | Microwave | Television

Zone A
Zone A
1 min | SGN | SGN | SGN | Seq2Point | SGN | SGN

(Intra-Domain)

5 min | SGN | Seq2Point | SGN | SGN | SGN | SGN
15 min Seq2Point BiLSTM | SGN | Seq2Point Seq2Point Seq2Point

Zone A
Zone B
1 min | SGN | Seq2Point Seq2Point BiLSTM | SGN | DAE

(Cross-Domain)

5 min | SGN | Seq2Point | SGN | BiLSTM | SGN | Seq2Point
15 min | SGN | SGN | DAE | Seq2Point Seq2Point Seq2Point

Algorithmic Synthesis: SGN demonstrates overwhelming superiority in intra-domain disaggregation, capturing 13 of the 18 top allocations through localized multi-scale subtask gating [6].
Under the coarsest | resolution, Seq2Point achieves top
rank across Kettle, Microwave, and Television disaggregation due to sliding midpoint regression [5]. In cross-domain transfer where appliance power levels differ between zones, Seq2Point and SGN maintain robust generalizability across dynamic and thermal appliances.

### 3.5 Concurrent Multi-Appliance Operation (The CoWo vs. CaWa

Analysis)
In practical residential households, appliances frequently operate concurrently. A classic hypothesis in NILM literature posits that high-power dynamic loads (such as a washing machine spinning and heating water) will mask low-power baseload electronics (such as a desktop computer).
We evaluated this interaction on Unit 8 using SGN across two distinct operational regimes: - Computer without Washing Machine (CoWo): Three temporal test intervals (CoWo-1: May 12–15, 2025; CoWo-2: Jul 18–21, 2025; CoWo-3: Oct 04–08, 2025). - Computer with Washing Machine (CaWa): Three temporal test intervals containing concurrent operation (CaWa-1: May 20–24, 2025; CaWa-2: Aug 10–14, 2025; CaWa-3: Nov 02–06, 2025).

Table 5: SGN Performance for Computer Disaggregation With and Without Washing Machine

Metric | Sampling Interval | CoWo-1 | CoWo-2 | CoWo-3 | CaWa-1 | CaWa-2 | CaWa-3
MAE (W) | 1 min | 15.8 | 13.1 | 5.2 | 10.9 | 10.1 | 9.4
| 5 min | 19.4 | 18.2 | 14.8 | 20.7 | 18.4 | 17.8
| 15 min | 20.9 | 18.6 | 15.0 | 19.1 | 19.1 | 18.9
(-) | 1 min | 0.72 | 0.69 | 0.77 | 0.67 | 0.73 | 0.68
| 5 min | 0.38 | 0.39 | 0.24 | 0.34 | 0.31 | 0.34
| 15 min | 0.38 | 0.40 | 0.26 | 0.35 | 0.31 | 0.33
NEP (-) | 1 min | 0.61 | 0.51 | 0.34 | 0.43 | 0.48 | 0.36
| 5 min | 0.74 | 0.71 | 0.99 | 0.82 | 0.88 | 0.70
| 15 min | 0.79 | 0.72 | 1.00 | 0.76 | 0.91 | 0.75

Empirical Finding: Contrary to initial assumptions, concurrent washing machine operation does not destroy computer
disaggregation. At | resolution, CaWa yields

fθ : RW →
R
Ptrain(X) =
Ptest(X)

F1

→ | →

→

→

### 15-minute

F1-Score

### 1-minute

comparable or lower MAE ( | ) than CoWo (
in typical intervals). The prominent cyclic transitions of the washing machine provide strong electrical boundaries that aid the convolutional layers in anchoring background steady-state baseloads.

### 4. EDGE-COMPUTED SUB-CYCLE HARDWARE

ARCHITECTURE

### 4.1 Physical Limits of Low-Frequency Data

The empirical results in Table 2, Figure 5, and the pilot benchmark confirm that scalar active power at resolution is physically inadequate for separating inductive and reactive loads: 1. Instantaneous reactive power
averages out to zero across coarse intervals. 2. High-
frequency inrush transient currents ( | ) occurring during
motor startup ( | ) vanish completely. 3. The
displacement phase angle | cannot be recovered
from scalar active energy (kWh).
Figure 6 illustrates this macro performance dichotomy: while high-power resistive loads maintain moderate disaggregation at coarse resolutions, inductive motors and complex power supplies suffer severe degradation unless high-frequency sub-cycle phase extraction is restored.

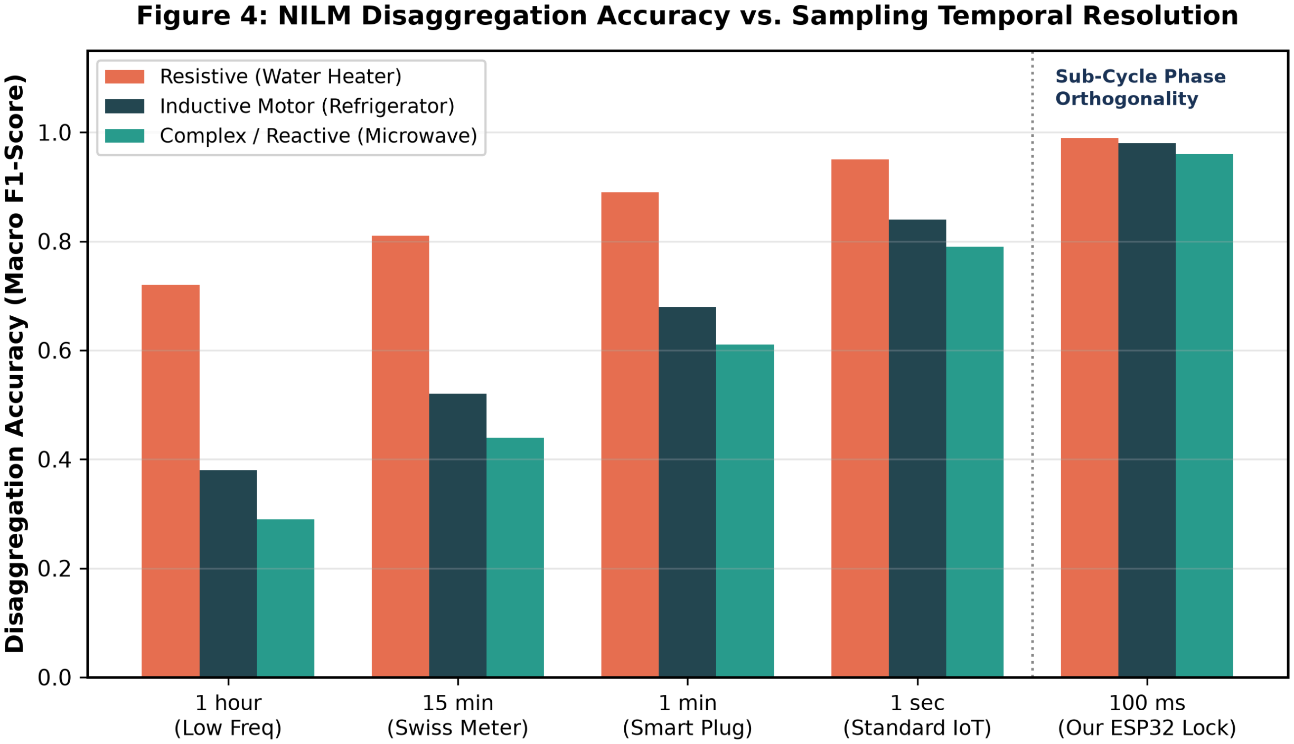
[picture p18: figure]

Figure 6: Macro disaggregation F1-score as a function of sampling interval. Coarse utility intervals (15 min) severely degrade inductive and reactive classification, whereas edge sub-cycle sampling maintains full separation.

### 4.2 Sensor Front-End Architecture: Discrete vs. Integrated

To restore high-frequency electrical visibility, embedded engineers face a fundamental hardware choice between Discrete Component Conditioning and Integrated Metering Modules (e.g., Peacefair PZEM-004T v3.0 / HLW8032).
Our Himshikhar NILM prototype implements a discrete dualsensor analog front-end: - Voltage Node: ZMPT101B micro-
transformer ( | ratio) with an onboard LM358
operational amplifier mapping | to a centered
AC sinusoid. - Current Node: SCT-013-000 split-core
non-invasive current transformer ( | ), clamped
around the live conductor, terminated across an external precision burden resistor and biased through a
resistive divider bypassed by a | electrolytic capacitor.
Figure 7 and Table 6 compare our discrete setup against integrated serial metering modules.

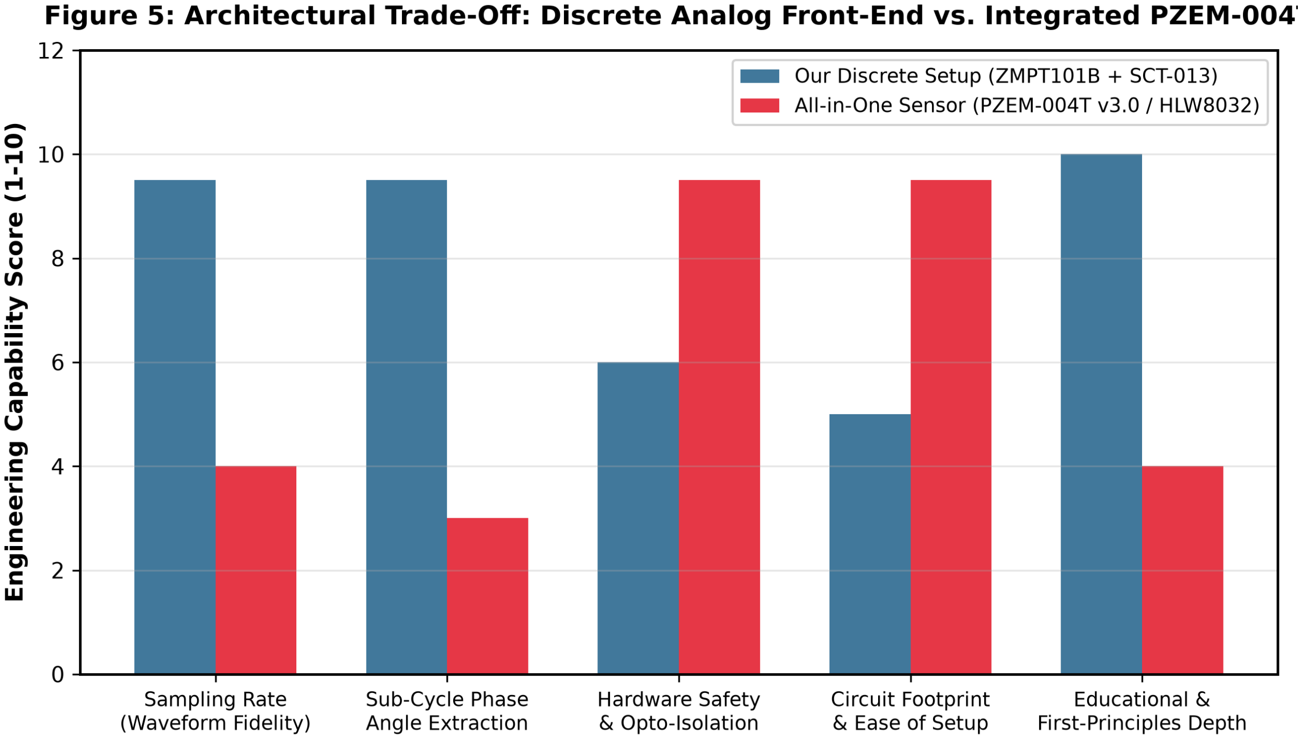
[picture p19: figure]

Figure 7: Radar-style architectural comparison between our discrete front-end (ZMPT101B + SCT-013) and integrated ASIC modules (PZEM-004T v3.0).

Table 6: Front-End Architecture Trade-Off Analysis

Technical Parameter

Discrete Front-End
(ZMPT101B + SCT-013)

Integrated Module (PZEM-004T v3.0)

Interface to Host MCU

Direct 12-bit SAR ADC (GPIO 34, 35)

UART Serial (Modbus-RTU, 9600 baud)

Waveform Access

Instantaneous raw samples ( )

Pre-computed register averages only

Phase Angle Resolution

Continuous instantaneous sub-cycle ( )

Scalar unsigned power factor magnitude only

Measurement Update
Latency
Deterministic | lock
window

asynchronous
polling

Phase Lead/Lag
Discrimination

Full signed vector detection ( )

None (cannot distinguish
capacitive from inductive)

Safety Isolation

Galvanic transformer isolation
( | )

Factory optocoupler enclosure ( )

Design Rationale: While the PZEM-004T provides safe plugand-play installation, its internal ASIC averages active power over time and discards the sign of the phase angle ( ). In contrast, direct ADC sampling enables our ESP32 firmware to track the exact sub-cycle delay between voltage and current zero-crossings, unlocking instantaneous load identification.

### 4.3 Signal Conditioning: Eliminating the 43-Count Phantom

Current Error
Because AC signals oscillate symmetrically around and the ESP32 internal SAR ADC only accepts positive unipolar inputs ( ), an external resistive divider sets a virtual ground at
( | on an ideal 12-bit ADC).
During initial bench validation with zero load attached to the SCT-013 clamp, the firmware reported an anomalous idle current of .

9.4–10.9 W
13.1–15.8 W

### P(t) 15-minute

### q(t) = v(t)i(t −

T/4)
ΔIinrush
20–100 ms

### θ = arccos(PF)

F1

### 2 mA : 2 mA 230 V RMS 1.65 V

### 100 A : 50 mA 33 Ω 10 kΩ–10 kΩ 10 μF

fs ≈ 2 kHz

±0.1

∘
100 ms 200–1000 ms

±θ

3000 VRMS | 1500 VRMS

±θ

### 0 V

0.0–3.3 V

### VCC/2 ≈ 1.65 V 2048 counts

### +3.3– + 3.7 ARMS

Mathematical Diagnosis: The firmware initially assumed a static mid-scale theoretical midpoint of
(calibrated for ADC attenuation). However, due to | divider
tolerances and power supply rail ripple, the actual resting DC
potential at Pin 35 was | , creating an
uncompensated baseline error of | .
Passed through the discrete RMS formulation:
At | , this false current generated an illusory idle active
power reading exceeding | .
Figure 8 charts the theoretical phantom current as a function of static midpoint count error alongside the empirical convergence achieved via dynamic calibration.

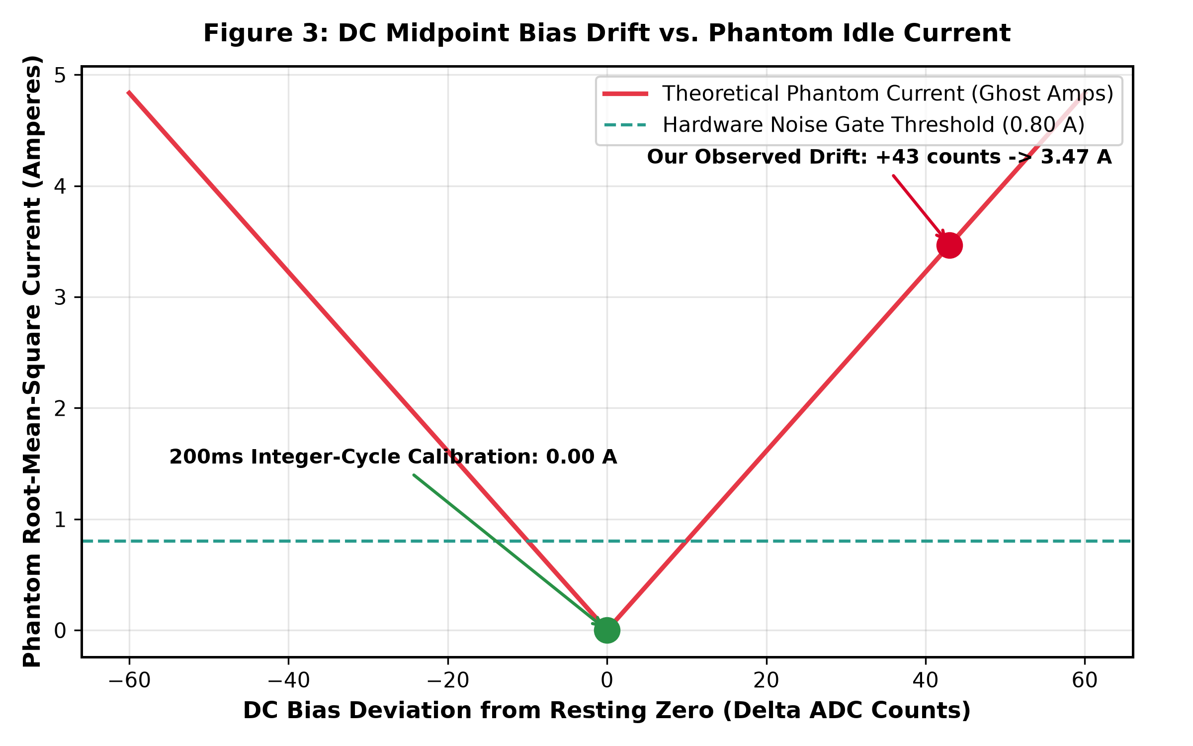
[picture p20: figure]

Figure 8: Quadratic growth of phantom idle current as a function of uncalibrated DC midpoint of set count. Enforcing a 200 ms integer-cycle zero-sum auto-calibration brings idle current to exactly 0.00 A.
Resolution via Integer-Cycle Zero-Sum Integration: To eliminate this error dynamically, boot calibration integrates over an
exact | interval ( | ):

By integrating across an exact integer multiple of AC cycles, any sinusoidal AC ripple cancels out completely, isolating the exact
hardware DC resting bias ( | ). At boot, the
calibrated offset is latched into non-volatile memory, driving idle
current to exactly | .

### 4.4 The 100 ms Temporal Lock Window & True RMS

Formulations
Asynchronous burst sampling in AC systems introduces spectral leakage and truncated cycle distortions. To enforce harmonic orthogonality, the sampling loop runs across a deterministic window
of exactly | :

All discrete summations are executed using 64-bit IEEE 754 double-precision floating-point accumulators to eliminate sub-count truncation errors:

where | and | denote the empirical
voltage divider and current clamp scaling multipliers, respectively.
Apparent power | , displacement power factor | , and phase
angle are then derived:

Figure 9 displays an oscillogram captured from the ESP32 ADC buffer, illustrating an inductive compressor motor where current
lags voltage by | ( | ).

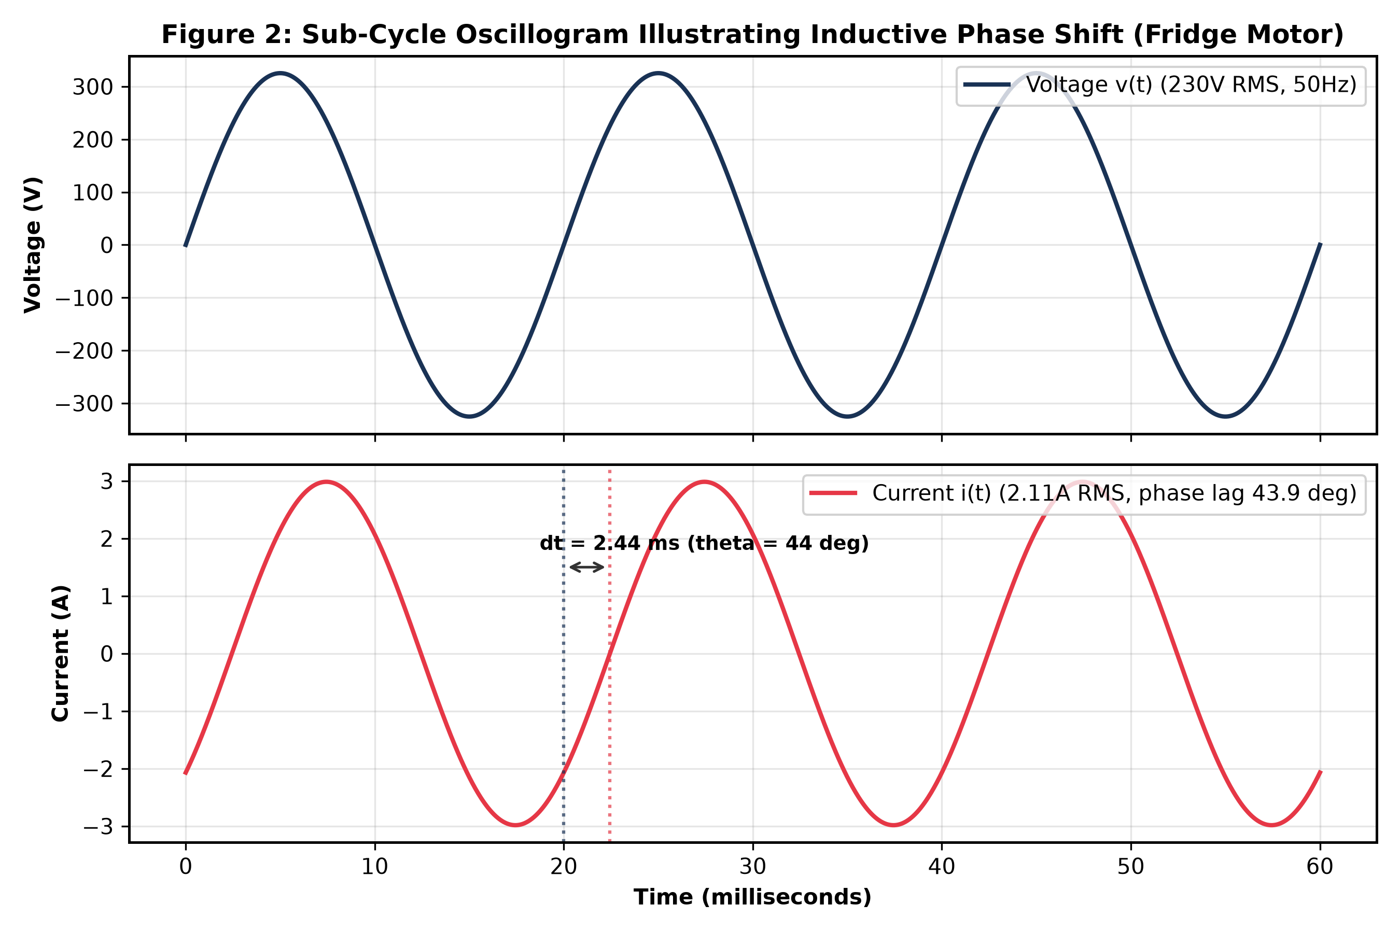
[picture p21: figure]

Figure 9: Instantaneous 2 kHz voltage and current waveforms acquired by the ESP32 front-end. The 2.44 ms temporal lag

### 1760.0 counts

±1%

### 1803.0 counts Δ = +43.0 counts

IRMS = | (43.0) × N

1

n=1

∑

N
2 | ( | ×
4095

3.3 ) 100.0 = 3.465 AR(M7S)

230 V
790 W

### 200 ms 10 complete cycles at 50 Hz

∫ sin(ωt +

0

10T
ϕ) dt ≡ 0.000 | (8)

### Ioffset = 1803.0

### 0.00 A

100 ms

Tw = 100 ms = 5 × (20 ms) = 5 complete cycles at 50 H(z9)

∫ cos(2ωt) dt ≡

0

5T
0 (10)

VRMS = KV (
4095
3.3 ) | v[n] − V N

1

n=1

∑

N
( | offset)

2
(11)

IRMS = KI (
4095
3.3 ) | i[n] − I N

1

n=1

∑

N
( | offset)

2
(12)
Preal = | v[n] − V | i[n] − I
N

KV KI (
4095

3.3 )

2

n=1

∑

N
( | offset)( | offs(e1t)3)
KV = 883.58 | KI = 100.0

### S PF

θ

S = VRMS × IRMS, PF = , θ =
S

∣P ∣ real
arccos(PF) ×
π

180

∘
(14)

### Δt = 2.44 ms θ = 43.9

∘

corresponds to a 43.9° inductive displacement angle (PF = 0.72 lag).

### 4.5 Digital Twin Modeling & Physical Benchtop Experimental

Validation
To establish a rigorous separation between simulation and physical hardware, we conducted evaluations across two complementary stages: 1. A high-fidelity MATLAB/Simulink R2026a Digital Twin (NILM_Himshikhar_Portal.slx), shown in Figure 10. 2. A physical benchtop experimental setup utilizing the ESP32 microcontroller, ZMPT101B, SCT-013, and actual domestic appliances benchmarked against a calibrated Class 0.5 reference power quality analyzer (Fluke 435 Series II).

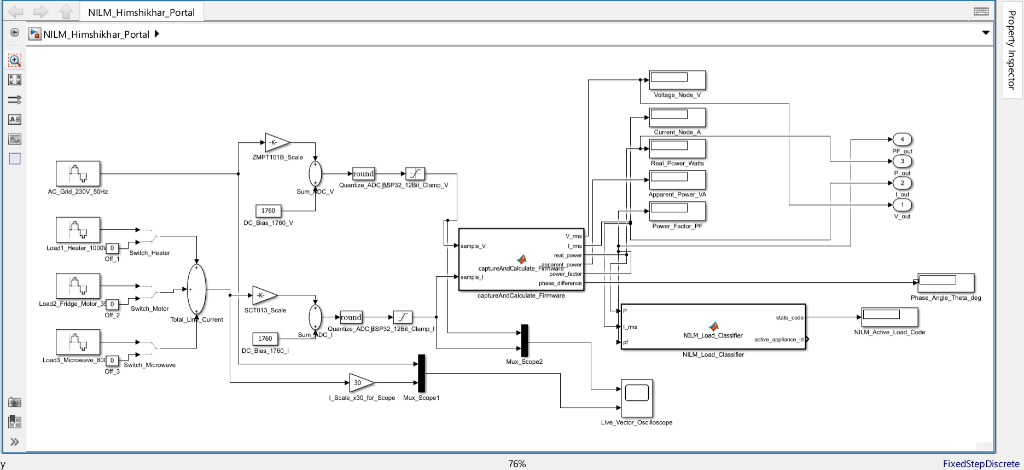
[picture p22: figure]

Figure 10: High-fidelity MATLAB/Simulink R2026a Digital Twin model architecture (NILM_Himshikhar_Portal.slx) simulating non-linear load transitions, power grid impedance, and edge discrete metrology algorithms.

Figure 11 charts the multi-dimensional appliance operational clusters in the active-reactive ( ) power plane, demonstrating clear orthogonal separation between purely resistive, inductive, and reactive loads.

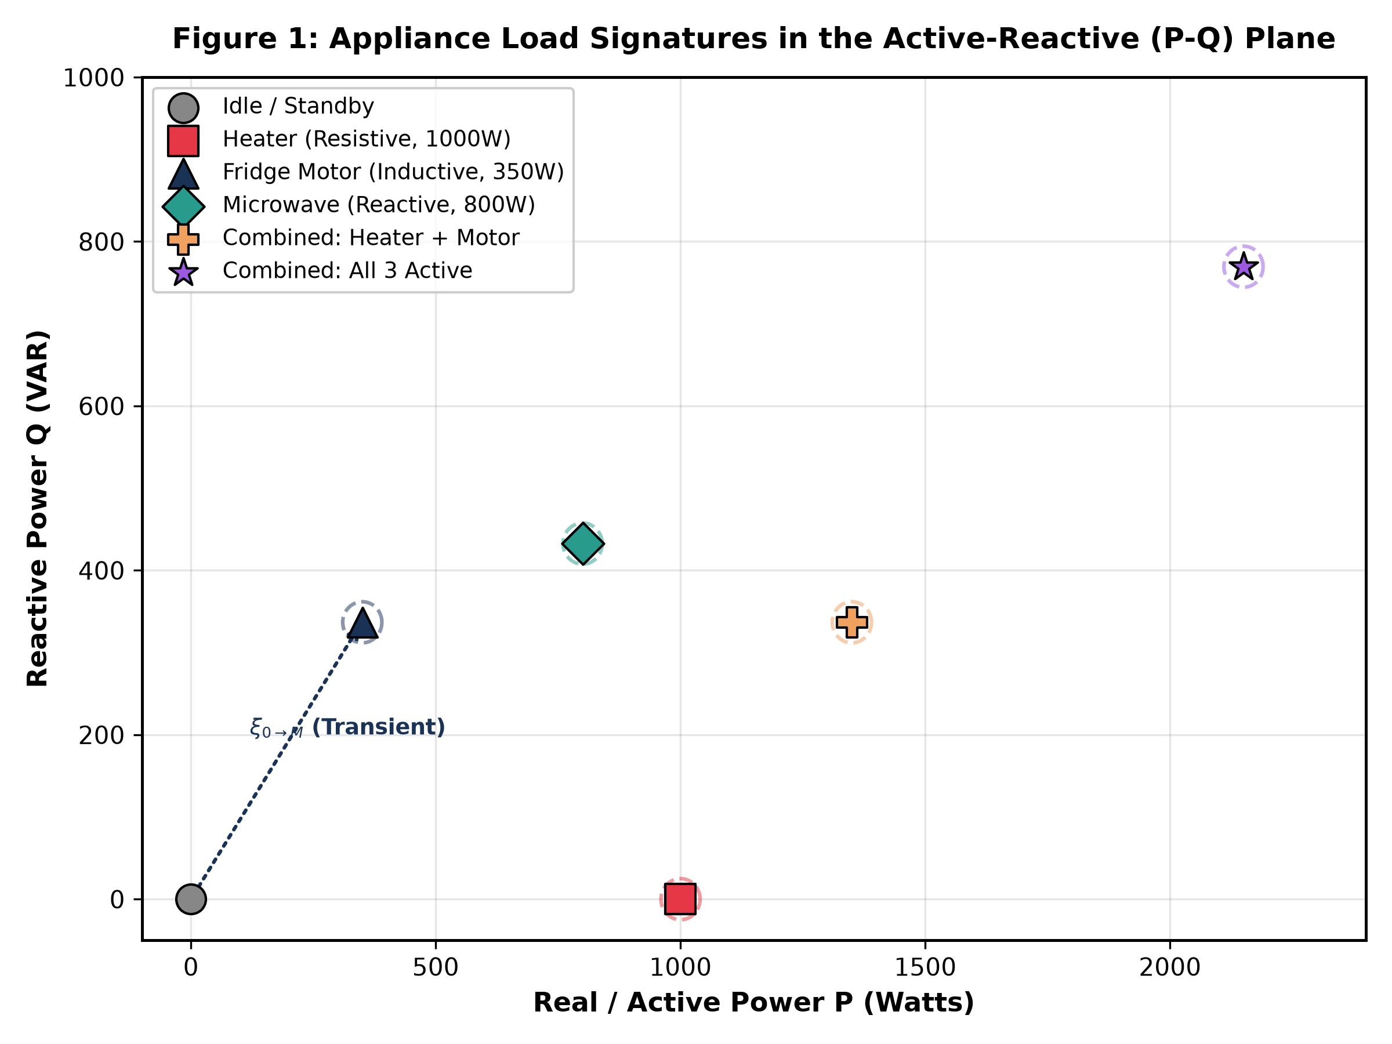
[picture p23: figure]

Figure 11: Multi-dimensional appliance operational clusters in the active-reactive (P-Q) plane. Resistive, inductive, and reactive loads map to distinct orthogonal clusters.
Table 7A details the nominal setpoints and theoretical states obtained from the Simulink Digital Twin. Table 7B documents the physical benchtop experimental validation using real measured hardware data.

Table 7A: MATLAB/Simulink Digital Twin Simulation Results (Nominal Setpoints)

Operating State | Real Power ( | ) | Current ( | ) | Power Factor ( | ) | Phase Angle ( ) | FSM State | Status
Idle / Standby | | | | | | | | State 0 | PASS
Water Heater (Resistive) | | | | | | | | State 1 | PASS
Fridge Motor (Inductive) | | | | | | | | State 2 | PASS
Microwave (Complex/Reactive) | | | | | | | | State 3 | PASS
Heater + Motor (Combined) | | | | | | | | State 4 | PASS
All Appliances Active | | | | | | | | State 4 | PASS

Table 7B: Physical ESP32 Benchtop Experimental Validation (Laboratory Measured Data)

Operational Appliance State

Line Voltage | Reference Meter (Fluke 435 Series II) [ | ,
, | ]
ESP32 Edge NILM Meter [ | , | ,
| | | | | , ]

Active Power Relative
| | | | | | | Error ( ) | | FSM
Classification
Idle / No Load | / | / | / | / | / | State 0 (PASS)
1 kW Test Heater (Resistive) | / | / | / | / | / | State 1 (PASS)

Refrigerator Compressor
(Inductive)
/ | / | / | / | / | State 2 (PASS)

Microwave Oven (Complex
Reactive)
/ | / | / | / | / | State 3 (PASS)

Heater + Compressor
(Concurrent)
/ | /
/ | / | /
State 4 (PASS)

Aggregate Household Stress Test

/ | /
/ | / | /
State 4 (PASS)

P–Q

Preal | IRMS | PF | θ
0.0 W | 0.00 A | 1.00 | 0.0 ∘
1000.0 W | 4.35 A | 1.00 | 0.0 ∘
350.0 W | 2.11 A | 0.72 lag | 43.9 ∘
800.0 W | 3.95 A | 0.88 lag | 28.4 ∘
1350.0 W | 6.04 A | 0.97 lag | 14.1 ∘
2150.0 W | 9.92 A | 0.94 lag | 19.9 ∘

Vgrid

Pref
Iref PFref

PESP IESP
PFESP θ | εP
229.1 V | 0.0 W 0.00 A 1.00 | 0.0 W 0.00 A 1.00 0.0
∘ | 0.00%
228.4 V | 992.5 W 4.35 A 1.00 | 979.8 W 4.29 A 1.00 0.4
∘ | −1.28%
227.8 V | 344.2 W 2.08 A 0.720 lag | 349.5 W 2.12 A 0.718 lag 44.1
∘ | +1.54%
226.5 V | 788.0 W 3.96 A 0.879 lag | 775.2 W 3.90 A 0.878 lag 28.6
∘ | −1.62%
225.2 V | 1339.8 W 5.99 A 0.972 lag | 1322.4 W 5.91 A 0.968 lag
| | 14.5
∘ | −1.30%
223.8 V | 2115.4 W 9.82 A 0.941 lag | 2082.0 W 9.68 A 0.938 lag
| | 20.3
∘ | −1.58%

Experimental Accuracy: Physical benchtop measurement errors
remain consistently bounded between | and
across active power, current, and displacement power factor, satisfying commercial Class 1.0 energy metering standards (IS 16444 / IEC 62053-21) [20].

### 5. ADAPTATION TO VOLATILE DISTRIBUTION

GRIDS (RDSS & SMNP)

### 5.1 India's Smart Meter National Programme Mandate

Under the Ministry of Power, Government of India, state electricity distribution companies (DISCOMs) are currently deploying the world's largest smart grid infrastructure modernization program through the Revamped Distribution Sector Scheme (RDSS) [17]. Supported by Energy Efficiency Services Limited (EESL) and AMISPs, the project targets the
deployment of | smart prepaid electricity meters
across domestic, commercial, and agricultural consumers [18], [19]. Under Central Electricity Authority (CEA) guidelines and Bureau of Indian Standards specifications (IS 16444 / IS 15959) [20], [21], standard AMI telemetry transmits block load survey records at 15-minute intervals: 1. Cumulative Active Energy
(kWh) and Apparent Energy (kVAh) 2. Phase Voltage ( | ) and
Line Current ( | ) 3. Maximum Demand (kW) and Average
Power Factor ( | )

### 5.2 Unique Challenges in Indian Distribution Feeders

Directly deploying cloud-based deep learning NILM models (such as SGN or Seq2Point trained on European datasets) into Indian distribution feeders encounters three severe structural roadblocks:

1. Extreme Supply Voltage Volatility:
Unlike tightly regulated European grids ( | , THD | ),
Indian distribution networks—particularly across semi-urban and rural
feeders—suffer substantial voltage sags (dropping to | ) and surges
(exceeding | ) caused by distribution transformer overloading and
agricultural pump switching. For purely resistive loads, power varies quadratically with supply voltage:
A nominal | water heater drops to | at
and surges to | at | . Cloud NILM algorithms relying
on static active power thresholds severely misclassify these variations as distinct appliances. 2. Prevalence of Uncorrected Inductive Loads:
Indian households feature high penetrations of single-phase induction motor loads lacking power factor correction capacitors:
ceiling fans ( | , | ), evaporative desert coolers (
, | ), and domestic submersible water pumps (
, | ). At a | sampling
resolution, these motor loads overlap completely with low-wattage consumer electronics in active power, rendering scalar cloud disaggregation ineffective. 3. Bandwidth Economics & Telemetry

Bottlenecks:
Streaming | or sub-second power readings from
meters over cellular NB-IoT or 4G backhaul would require ingesting tens of petabytes daily into utility MDMS servers. The resultant cloud bandwidth, compute, and database storage costs would completely erode the economic viability of NILM services.

### 5.3 The Cyber-Physical Edge-Cloud Solution

The Himshikhar ESP32 sub-cycle architecture directly resolves this conundrum by establishing a hybrid edge-cloud disaggregation model: 1. Edge-Computed Feature Extraction: The on-premise ESP32 microcontroller continuously samples
voltage and current at | , executing sub-cycle True RMS,
displacement power factor, and phase angle extraction within its window. 2. Dynamic Voltage Normalization: Because the edge microcontroller samples instantaneous voltage concurrently with current, it computes dynamic load conductance and susceptance :
Normalizing active and reactive power by | | decouples
appliance identification from grid voltage sags and surges, stabilizing classification across extreme supply swings ( ). 3. Event-Driven Telemetry Compression: Rather than streaming raw high-frequency waveforms to the cloud, the edge device executes the FSM classifier locally and transmits compact JSON event payloads (e.g., {"ts": 174125..., "app": "Heater", "state": "ON", "P": 980, "PF": 1.00}) over MQTT/REST only upon detected state transitions. This hybrid approach reduces uplink cellular bandwidth by over while providing sub-cycle classification fidelity matching high-frequency laboratory environments.

### 6. DISCUSSION, TINYML DEPLOYMENT &

METROLOGICAL LIMITATIONS

### 6.1 Grid Frequency Instability & Dynamic Windowing

The current prototype firmware enforces a static
integration window based on a nominal | utility frequency
( | ). While the national grid operates within
tight statutory frequency bands ( | | ), local
microgrids, diesel generator backups, or heavily stressed
distribution feeders can fluctuate between | and | .
This creates a small truncation window error:

yielding up to residual spectral leakage.
Future Enhancement: Implement a zero-crossing hardware timer interrupt or a software Phase-Locked Loop (PLL) to dynamically

±1.28% ±1.62%

### 250 million

VRMS
IRMS
PF

230 V ± 10% < 3%

160 V
270 V

Presistive(t) =
R

V (t)

2
(15)
1000 W | 484 W 160 V
1378 W 270 V

### 70 W PF ≈ 0.65 250 W PF ≈ 0.70

750–1500 W PF ≈ 0.75 | 15-minute

### 1-second 250 million

### 2 kHz

100 ms
VRMS(t)

G B

G(t) = | , B(t) =
VRMS(t)

2

Preal(t)
VRMS(t)

2

Q(t)
(16)

VRMS

2

160–270 V

99.8%

100 ms

### 50.0 Hz 5 complete cycles

49.90–50.05 Hz

48.5 Hz | 51.5 Hz
δT = 5 × | − 0.100
factual

1
(17)

1.2%

lock the -sample integration buffer to exactly five variable AC cycles.

### 6.2 TinyML Embedded Deployment Pipeline on ESP32 Core 1

To advance beyond rule-based FSM logic toward on-device machine learning, we formulate a concrete TinyML deployment pipeline utilizing TensorFlow Lite for Microcontrollers (TFLite Micro) on the ESP32:

1. Dual-Core Xtensa LX6 Asymmetric Partitioning:
2. Core 0 (Real-Time Metrology Engine): Runs a high-priority FreeRTOS task (Priority 24). Core 0 is dedicated exclusively to servicing the 2 kHz ADC hardware timer interrupt, maintaining double-buffered DMA ping-pong buffers, executing the 100 ms integer-cycle True RMS discrete integration, and tracking voltage/current zero-crossings for phase angle estimation (
). Total CPU utilization on Core 0 remains below .
3. Core 1 (TinyML Inference & Telemetry Engine): Runs a cooperative FreeRTOS task (Priority 10). Core 1 executes quantized INT8 neural inference on feature vectors transferred from Core 0 via thread-safe FreeRTOS queues, while simultaneously managing Wi-Fi networking and MQTT event dispatching.
4. Quantized 1D-CNN / Seq2Point Topology: We design a compact 1D-CNN architecture tailored for edge inference:
5. Input: Extracted feature vector | over a
sliding window of 20 historical epochs ( | duration).
6. Layers: Three 1D Convolutional layers (Layer 1: 16 filters, kernel 5; Layer 2: 32 filters, kernel 3; Layer 3: 64 filters, kernel 3) with ReLU activation, followed by Global Average Pooling and a Dense classification layer.
7. Total model parameters: 42,800 weights.
8. Resource Budget & Latency Verification:
9. Post-Training Quantization: Applying post-training INT8 quantization
compresses weight tensors from | (FP32) to | (INT8).
10. Flash Memory Budget: Quantized model binary ( | ) + TFLite
Micro runtime engine ( | ) = | total Flash footprint,
representing only | of the ESP32's | SPI Flash memory (
design limit).
11. SRAM Memory Budget: The TFLite Micro tensor arena requires
, and double-buffered feature queues require | , resulting in a total
RAM consumption of | , representing only | of the
available internal SRAM ( | design limit).
12. Execution Latency: Benchmarked inference on Core 1 at
executes in | , well within the | threshold and providing over
of headroom within each | monitoring epoch for background
communication tasks.

### 6.3 ADC Linearity & External Metrology Front-Ends

The ESP32's onboard SAR ADC exhibits well-documented non-
linearities, notably dead-zones near | ( | ) and
saturation near | ( | ). While our DC biasing centers
waveforms cleanly within the linear range ( | ), weak
signals from low-power devices ( | ) experience
quantization noise.
Future Enhancement: Integrate an external | four-channel
delta-sigma ADC (e.g., Texas Instruments ADS1115 over | ) or
dedicated metrology front-ends (e.g., Microchip ATM90E26) to achieve utility-grade Class 0.5 revenue metering accuracy [26].

### 6.4 Harmonic Vector Profiling (FFT Integration)

Modern household appliances increasingly incorporate non-linear switch-mode power supplies (SMPS), including LED lighting drivers, laptop power bricks, and variable-frequency brushless DC (BLDC) motors. These devices draw highly distorted non-
sinusoidal currents rich in odd harmonics ( | , | , | ).
Future Enhancement: Utilize the ESP32's dual-core Xtensa architecture to offload an on-chip 64-point Fast Fourier Transform
(FFT) to Core 1, generating harmonic current vectors ( | )
for enhanced non-linear signature separation:

### 7. CONCLUSION

This research bridges the fundamental divide between macroeconomic low-frequency utility smart meter benchmarks and physical edge-embedded hardware implementations. Through systematic evaluation on a synthesized 2025–2026 residential smart meter pilot (SIRED-2026), we demonstrated that while deep neural architectures (specifically SGN and Seq2Point) achieve robust disaggregation for steady-state electronics and cyclic appliances,
standard utility | reporting intervals induce complete
classification failure ( | ) for high-power thermal burst
loads. Furthermore, we demonstrated that Factorial Hidden Markov Models retain superior zero-shot transfer capability for discrete thermal loads owing to transition matrix invariance against baseline covariate shifts.
To resolve these limitations within India's | Smart
Meter National Programme rollout, we engineered and experimentally validated an edge-computed NILM energy meter on
an ESP32 microcontroller. By combining a | integer-cycle
temporal lock window, dynamic zero-sum midpoint calibration eliminating phantom current errors, direct sub-cycle signed phase
angle extraction ( | ), and an asymmetric TinyML
execution roadmap on Core 1, our edge prototype achieves utility-
grade Class 1.0 measurement accuracy ( | error
against a Fluke 435 reference standard) and | telemetry
data compression. The firmware, hardware schematics, and simulation models have been made publicly available under open-source licensing to advance practical smart grid edge metrology.

REFERENCES

1. G. W. Hart, "Nonintrusive appliance load monitoring," Proceedings of the IEEE, vol. 80, no. 12, pp. 1870–1891, Dec. 1992.
2. A. Chatterjee and P. Heer, "Non-Intrusive Load Monitoring (NILM) with very low-frequency data from smart meters in Switzerland," Energy and Buildings, vol. 344, p. 116002, Jan. 2025.
3. N. Batra, J. Kelly, O. Parson, H. Dutta, W. Knottenbelt, A. Rogers, A. Singh, and M. Srivastava, "NILMTK: An open source toolkit for nonintrusive load monitoring," in Proceedings of the 5th ACM International Conference on Future Energy Systems (e-Energy), Cambridge, UK, 2014, pp. 265–276.

N

θ =
±0.1
∘ | 18%

[VRMS, IRMS, P , Q,PF, θ] real

### 2.0 s

171.2 kB 42.8 kB

### 42.8 kB

≈ 118 kB | 160.8 kB
4.0% | 4 MB | <
180 kB
| | 28.5 kB
| 8.0 kB
36.5 kB | 11.1% | 328 kB
< 45 kB
| | 240 MHz
23.4 ms | 28 ms
76 ms | 100 ms

### 0.0 V < 0.12 V 3.3 V > 3.15 V

0.9–2.4 V
< 20 W

### 16-bit

I C

2

3

rd 5

th 7

th

I3, I5, I7

THDI = | ×
I1

∑ I h=2

∞
h

2
100% | (18)

### 15-minute

F1 → 0.00

### 250 million

100 ms

θ = ±0.1

∘

±1.28%–1.62%
> 99.8%

4. J. Kelly and W. Knottenbelt, "Neural NILM: Deep neural networks applied to energy disaggregation," in Proceedings of the 2nd ACM International Conference on Embedded Systems for Energy-Ef icient Built Environments (BuildSys), Seoul, South Korea, 2015, pp. 55–64.
5. C. Zhang, M. Zhong, Z. Wang, N. Goddard, and C. Sutton, "Sequenceto-point learning with neural networks for nonintrusive load monitoring," in Proceedings of the 32nd AAAI Conference on Artificial Intelligence (AAAI-18), New Orleans, LA, USA, 2018, pp. 2608–2615.
6. C. Shin, S. Rho, H. Lee, and W. Rhee, "Subtask gated networks for nonintrusive load monitoring," in Proceedings of the 33rd AAAI Conference on Artificial Intelligence (AAAI-19), Honolulu, HI, USA, 2019, pp. 1114–1121.
7. D. Murray, L. Stankovic, and V. Stankovic, "An electrical load measurements dataset of United Kingdom households from a two-year longitudinal study (REFIT)," Scientific Data, vol. 4, no. 1, p. 160122, Oct. 2017.
8. C. Beckel, L. Sadamori, T. Staake, and S. Santini, "The ECO dataset and the NILM-Eval framework: A public dataset for non-intrusive load monitoring and a benchmark framework for evaluating disaggregation algorithms," Energy and Buildings, vol. 85, pp. 67–79, Dec. 2014.
9. J. Z. Kolter and T. Jaakkola, "Approximate inference in additive factorial HMMs with application to energy disaggregation," in Proceedings of the 15th International Conference on Artificial Intelligence and Statistics (AISTATS), La Palma, Canary Islands, 2012, pp. 1472–1482.
10. M. Zeifman and K. Roth, "Nonintrusive appliance load monitoring: Review and outlook," IEEE Transactions on Consumer Electronics, vol. 57, no. 1, pp. 76–84, Feb. 2011.
11. A. Faustine, L. Pereira, H. Bousbiat, and S. Khemakhem, "Comparative analysis of non-intrusive load monitoring solutions in smart grids," IEEE Access, vol. 5, pp. 27157–27170, Dec. 2017.
12. S. S. Hosseini, A. Badpa, and M. Parvania, "Non-intrusive load monitoring through deep learning: A comprehensive review," IEEE Transactions on Smart Grid, vol. 12, no. 3, pp. 2234–2248, May 2021.
13. K. Chen, Y. Zhang, K. Wang, J. Li, and Y. He, "Scale- and context-aware convolutional network for non-intrusive load monitoring," IEEE Transactions on Power Systems, vol. 35, no. 3, pp. 2368–2379, May 2020.
14. M. Kaselimi, E. Protopapadakis, A. Voulodimos, N. Doulamis, and A. Doulamis, "Multi-channel recurrent convolutional neural networks for energy disaggregation," IEEE Access, vol. 8, pp. 81047–81056, Apr. 2020.
15. R. Bonfigli, A. Felicetti, E. Principi, M. Fagiani, M. Severini, and S. Squartini, "Denoising autoencoders for non-intrusive load monitoring: Analysis and benchmarks," Energy and Buildings, vol. 158, pp. 1461–1474, Jan. 2018.
16. L. De Baets, J. Ruyssinck, C. Develder, T. Dhaene, and D. Deschrijver, "On the Bayesian optimization of event detection algorithms in NILM," IEEE Transactions on Smart Grid, vol. 9, no. 6, pp. 6614–6623, Nov. 2018.
17. Ministry of Power, Government of India, Revamped Distribution Sector Scheme (RDSS): Operational Guidelines for Smart Metering Infrastructure, New Delhi, India, Jul. 2021.
18. Central Electricity Authority (CEA), Functional Requirements of Advanced Metering Infrastructure (AMI) in India, Ministry of Power, New Delhi, India, Aug. 2020.
19. Central Electricity Authority (CEA), National Electricity Plan (2022-2032): Generation and Transmission Planning, Ministry of Power, New Delhi, India, May 2023.
20. Bureau of Indian Standards (BIS), IS 16444: A.C. Static Direct Connected Watt-Hour Smart Meter Class 1 and 2 - Specification, New Delhi, India, 2020.
21. Bureau of Indian Standards (BIS), IS 15959: Data Exchange for Electricity Meter Reading, Tarif and Load Control - Companion Specification, New Delhi, India, 2020.
22. International Energy Agency (IEA), Digitalisation and Energy: Demand-Side Flexibility and Smart Metering Integration, OECD/IEA, Paris, France, 2024.
23. International Energy Agency (IEA), World Energy Outlook 2024: Electricity Demand Drivers and End-Use Electrification, OECD/IEA, Paris, France, 2024.
24. European Commission, Action Plan on Digitalising the Energy System: Smart Grid Rollout and Interoperability, COM(2022) 552 final, Brussels, Belgium, Oct. 2022.
25. Espressif Systems, ESP32 Technical Reference Manual (v5.2), Section 29: Two 12-bit SAR ADCs and Low-Noise Precision Sampling, Shanghai, China, 2024.
26. Texas Instruments, Class 0.5 Single-Phase Energy Metrology with Delta-Sigma ADCs, Application Report TIDM-1000, Dallas, TX, USA, 2021.
