manttii/Himshikhar-NILM-ESP32/(commit log)

2026-10-12 feat: initial commit of Himshikhar NILM ESP32 firmware, simulink model, and hardware docs
2026-10-12 fix: resolve integer truncation in discrete RMS summation, lock boot calibration to 200ms integer cycles, add reverse CT auto-correction, and upgrade web portal to asynchronous REST polling
    [esp32_nilm_meter.ino]
2026-10-12 feat(docs): add 5 publication-grade research figures (PQ plane, subcycle waveforms, phantom drift, Swiss smart meter benchmark, and sensor architecture comparison)
2026-10-12 fix(paper): resolve Table 4 ground-truth discordances, harmonize Figure 3 end-use text, and restore Fig 3 in generator script
